hotwolf/TicTacToe/Hardware/RevA/Laser/OPILite/Order 54053/Design.dxf

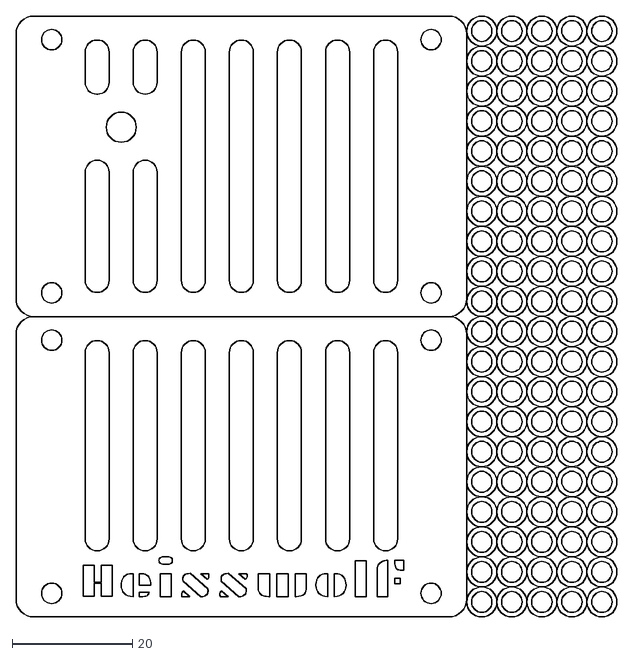
[picture p3: CAD file, 2017-04-25]
Hardware/RevA/Laser/OPILite/Order 54053/Design.dxf
100.0 x 100.0
