hotwolf/TicTacToe/Hardware/RevA/Laser/Plate/Order 53656/Design1.dxf

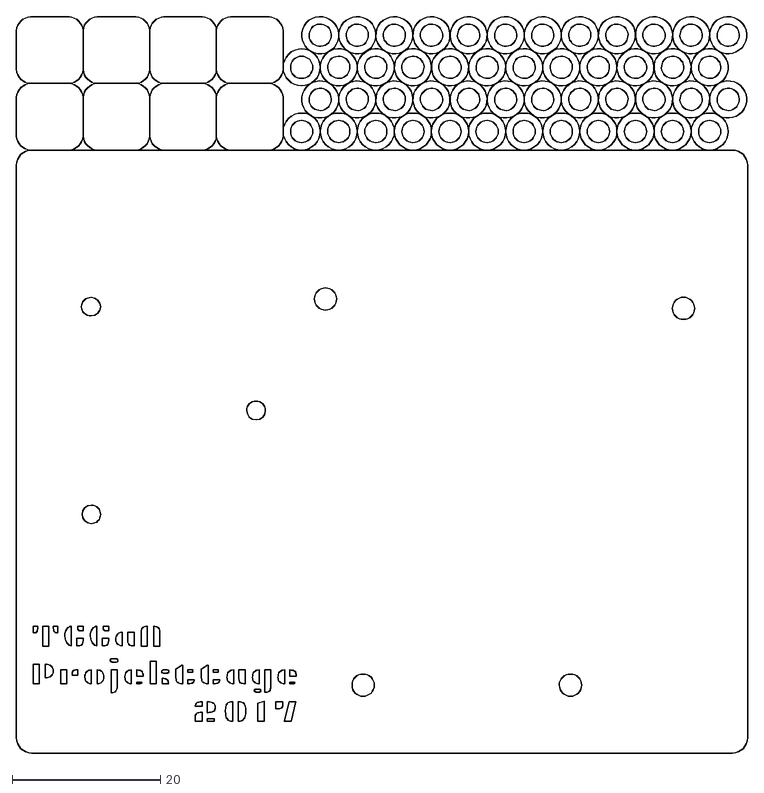
[picture p4: CAD file, 2017-04-25]
Hardware/RevA/Laser/Plate/Order 53656/Design1.dxf
98.6 x 99.4
