hotwolf/TicTacToe/Hardware/RevA/Laser/OPILite/Order 54053/Readme.pdf

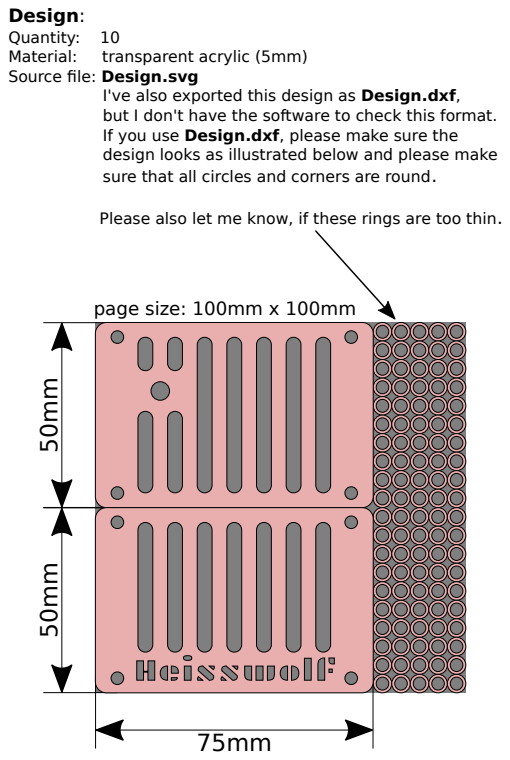
[picture p6: page 1]
Material:; transparent acrylic (5mm); page size: 100mm x 100mm

Design:
Quantity: 10
Source file: Design.svg

I've also exported this design as Design.dxf,
but I don't have the software to check this format.
If you use Design.dxf, please make sure the
design looks as illustrated below and please make
sure that all circles and corners are round.

Please also let me know, if these rings are too thin.
