hotwolf/TicTacToe/Hardware/RevA/TicTacToe-RevA Assembly Plan.pdf

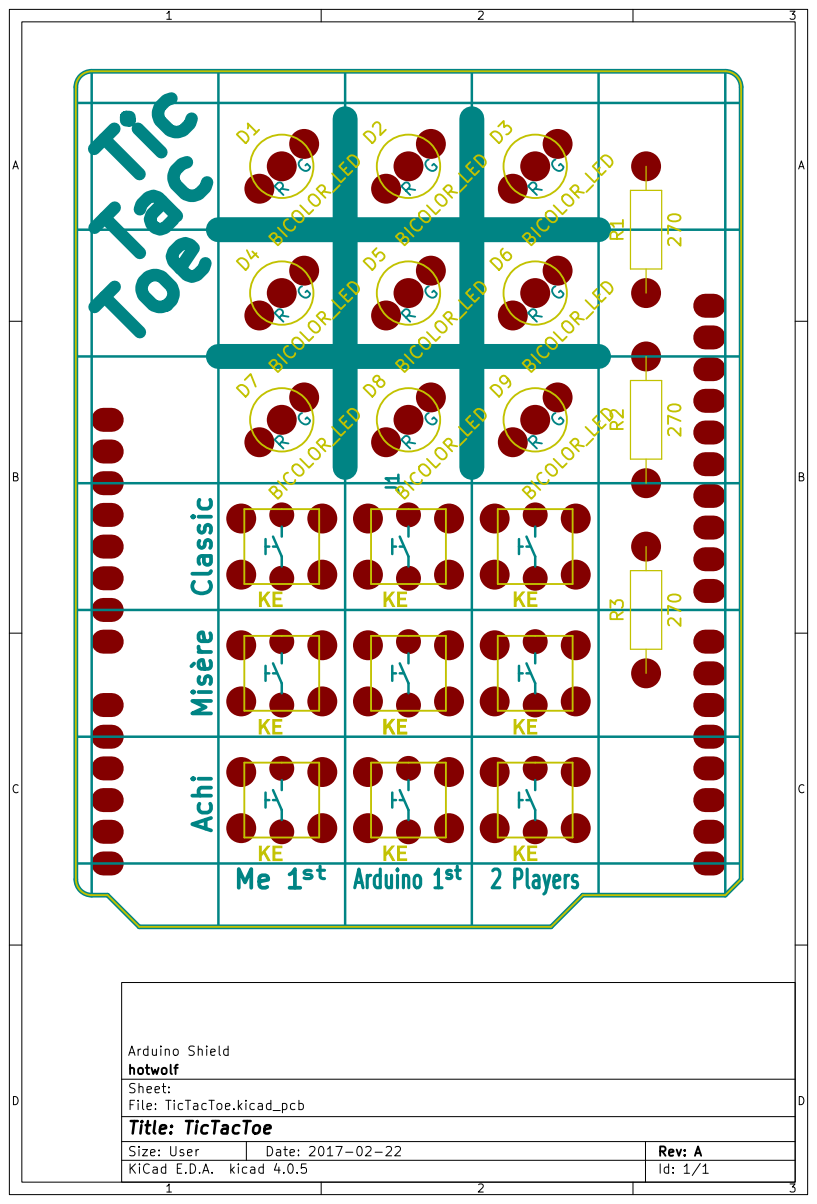
[picture p7: page 1]
