hotwolf/TicTacToe/Hardware/RevA/TicTacToe-RevA Schematic.pdf

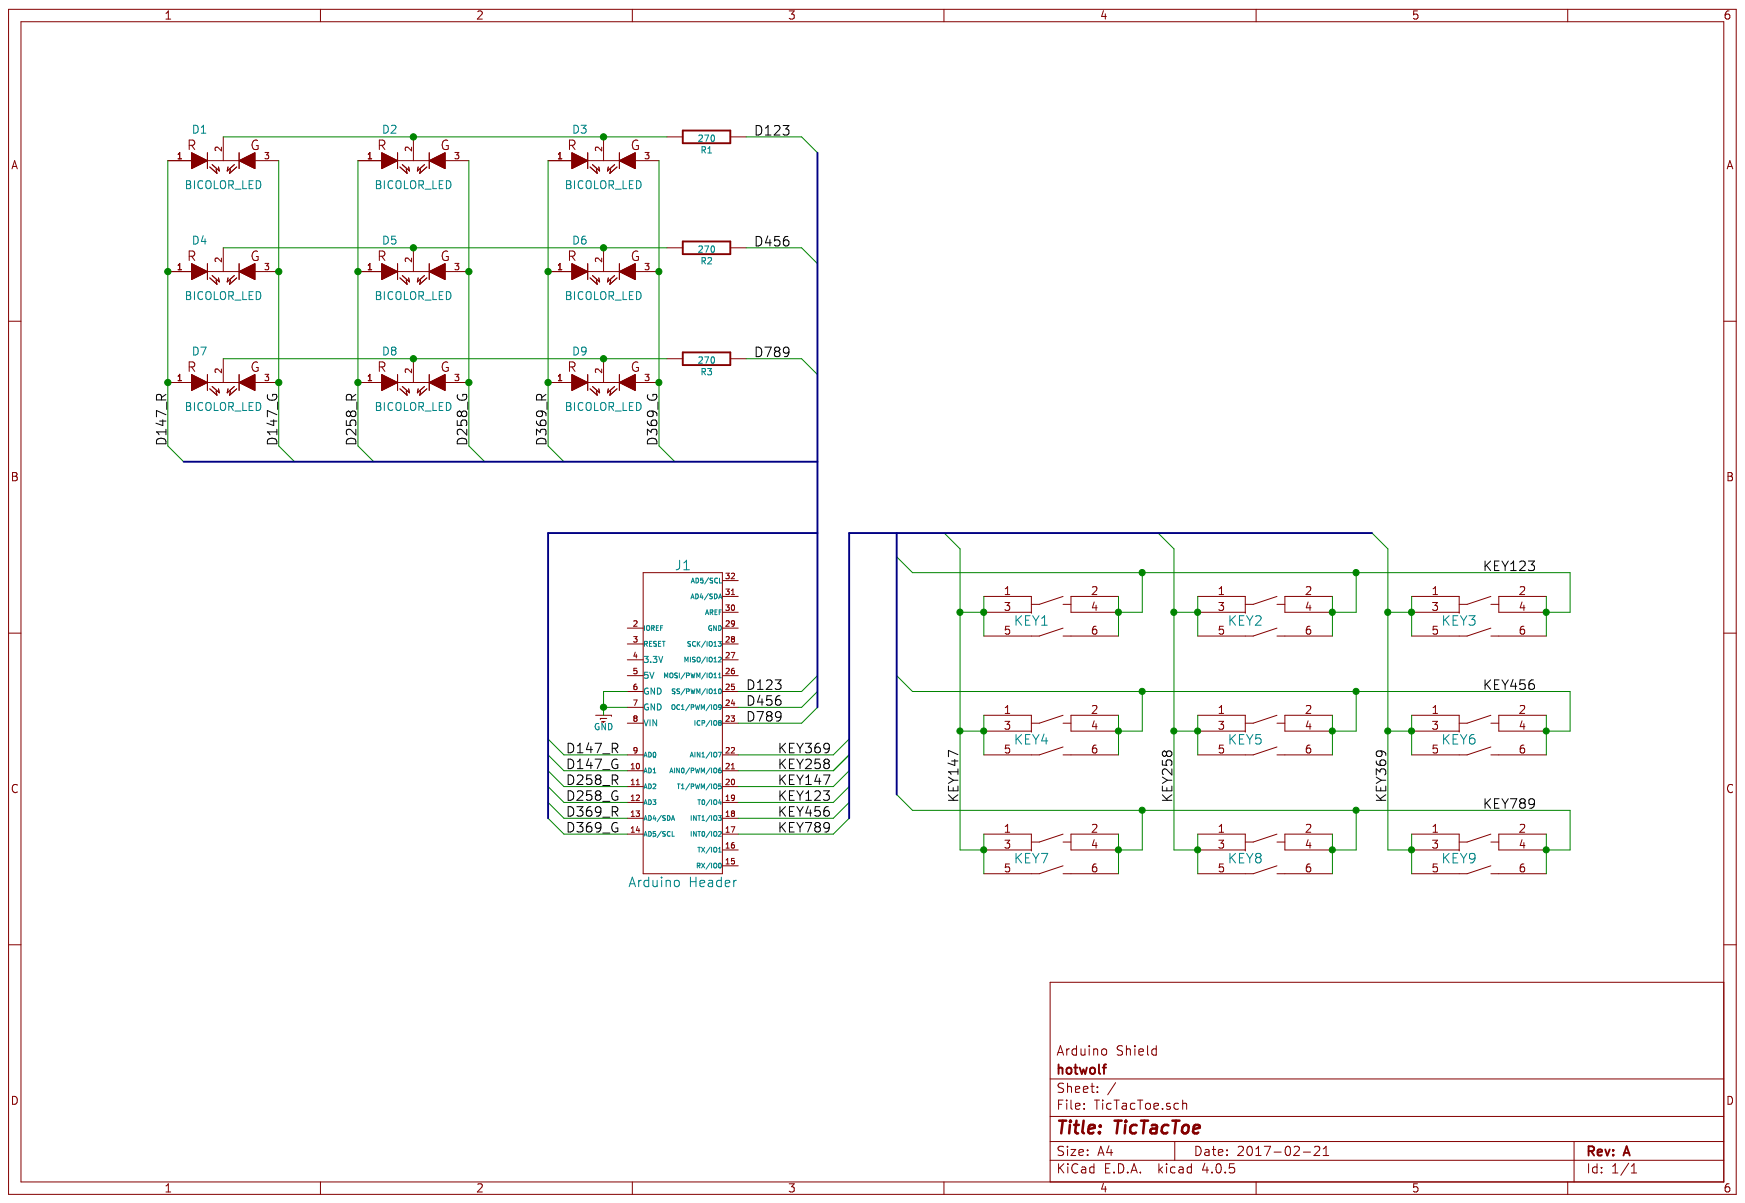
[picture p8: page 1]
