hotwolf/TicTacToe/Software/Lab4/Lab4.ino

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
#include "TicTacToe.h"

// Variables
//===========
fields gameSelection;
  
// Setup routine
//===============
void setup() {
  //Serial library
  //Serial.begin(9600);
  //Serial.println("Lab4!");

  //Random seed
  randomSeed(analogRead(0));
  
  //Display
  dispSetup();

  //Keypad
  keysSetup();

  //Intro text
  //Control characters: \x80 = loop
  //                    \x81 = display red text
  //                    \x82 = display green text
  //                    \x83 = display bicolor (red+green) text
  //                    \x84 = start of the loop
  //  
  //          green    red    green     loop
  //            V       V       V        V 
  //textShow("\x82TIC \x81TAC \x82TOE \x80");

  textShow("...put your own text here...\x80");  

  gameSelection = getKey();
  textStop();

}

// Game loop
//===========
void loop() {
  //Clear display
  red        = 0;
  green      = 0;
  scanRed    = 0;
  scanGreen  = 0;
  blinkRed   = 0;
  blinkGreen = 0;
  
  //Determine players
  if (gameSelection & 0b001001001) {
    //Me 1st
    greenIsHuman = true;
    redIsHuman   = false;
  } else if (gameSelection & 0b010010010) {
    //Arduino 1st
    greenIsHuman = false;
    redIsHuman   = true;
  } else {
    //Two players
    greenIsHuman = true;
    redIsHuman   = true;
  }
  
  //Start Game
  if (gameSelection & 0b000000111) {
    //Classic
    classicPlay();
  } else if (gameSelection & 0b000111000) {
    //Misere
    miserePlay();
  } else {
    //Achi
    achiPlay();
  }

  //Next game
  gameSelection = getKey();
}
