hotwolf/TicTacToe/Software/TicTacToe/TicTacToeDisp.ino

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
#include <Arduino.h>
#include <avr/sleep.h>
#include <avr/power.h>
#include "TicTacToe.h"

// Constants
//===========

// Variables                                
//===========
//Display buffer                                
fields       dispRedBuf     = 0;    //red display buffer
fields       dispGreenBuf   = 0;    //green display buffer

//Column index
byte         dispColumn     = 0;    //current column

//Pre-calculated port output
byte         dispNextPortB  = 0x07; //next port B output
byte         dispNextPortC  = 0x00; //next port C output

//Highlighting
signed char  dispHighlightCount = 0;//blink interval
fields       dispHighlightIndex = 0;//scan index
 
// Setup routine
//===============
void dispSetup() {
  //Initialize the display
  PORTB   &= 0xF8;
  PORTC   |= 0x3F;
  DDRB    |= 0x07;
  DDRC    |= 0x3F;

  //Initialize timer 2
  TCCR2A = 0;                               //normal mode
  //TCCR2A = (1 << WGM21);                  //CTC mode, no pin toggling
  TCCR2B = (1 << CS22) |                    //set timer clock to 15.625kHz
           (1 << CS21) |
           (1 << CS20);
  OCR2A  = 15625/(6*FRAMERATE);              //set interrupt frequency
  OCR2B  = 0;                               //
  TIFR2  = (1 << OCF2B) |                   //clear output compare B interrupt flag
           (1 << OCF2A);                    //clear output compare A interrupt flag
  TIMSK2 = (1 << OCIE2A);                   //enable output compare A interrupt
  
  //Power modes
  power_timer2_enable();                    //make sure timer2 is powered up
  set_sleep_mode(SLEEP_MODE_IDLE);          //use idle mode
  sleep_enable();                           //enable sleep instruction
}

// Interrupt Service Routines
//============================
//Timer2 output compare A interrupt
ISR(TIMER2_COMPA_vect){                     //timer2 output compare A interrupt
  fields tmpBuf;                            //intermediate display buffer

  //Debug code
  //digitalWrite(13, HIGH);                 //turn LED on during the execution of the ISR
  //digitalWrite(13, !digitalRead(13));     //turn LED on during the execution of the ISR

  //Prepare next delay 
  //OCR2A += 15625/(6*FRAMERATE);             //set new delay
  OCR2A =  (dispColumn & 1) ?                //compensate for different brightness
    OCR2A + ((15625*1.7)/(6*FRAMERATE)) :     //green
    OCR2A + ((15625*0.3)/(6*FRAMERATE));      //red
 
  //Drive previously calculated output
  PORTB |= 0x07;                            //turn off all LEDs
  PORTC  = dispNextPortC;                   //set new anode pattern
  PORTB &= dispNextPortB;                   //select new cathode column  
   
  //Update column
  dispColumn = ((dispColumn + 1) % 6);      //advance column indax

  //Update content
  if (!dispColumn) {                        //start of frame
    if (dispAnimator == NULL) {             //no custom animator

      //Set solid pattern
      dispRedBuf   = red;
      dispGreenBuf = green;

      //Highlighting
      if (++dispHighlightCount > (FRAMERATE/2)) {//advance blink interval
        dispHighlightCount = -(FRAMERATE/2);     //restart blink interval
        dispHighlightIndex = 0x001;             //restart scan
      } else if (dispHighlightCount > 0) {
  
        //Set blink pattern
        dispRedBuf   ^= blinkRed;
        dispGreenBuf ^= blinkGreen;

        //Set scan pattern
        if (!(dispHighlightCount % (FRAMERATE/(2*9)))) {//time to advance scan index
          while (dispHighlightIndex &&         
                (!(dispHighlightIndex & (scanRed | scanGreen)))) {
            dispHighlightIndex <<= 1;
          }
          //Serial.println(dispHighlightIndex, BIN);
          dispRedBuf   ^= (dispHighlightIndex & scanRed);
          dispGreenBuf ^= (dispHighlightIndex & scanGreen);
          dispHighlightIndex <<= 1;
        }
      }  
    } else {  
      //Run custom animation routine  
      dispAnimator(&dispRedBuf, &dispGreenBuf);   
    }
  }

  //Calculate next port output
  dispNextPortC = (0x01 << dispColumn);     //set cathode column
  tmpBuf = (dispColumn & 1) ?
    dispGreenBuf >> (dispColumn >> 1) :     //use green buffer
    dispRedBuf   >> (dispColumn >> 1);      //use red buffer
  dispNextPortB =
    ~(((tmpBuf & 0x40) >> 6) |              //set top row
      ((tmpBuf & 0x08) >> 2) |              //set center row
      ( tmpBuf & 0x01) << 2);               //set bottom row

  //Debug code
  //digitalWrite(13, LOW);                  //turn LED off
}
