hotwolf/TicTacToe/Software/Lab3/Lab3Exercise.ino

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
#include "TicTacToe.h"

// classicPlay()
//===============
//Play the classic game
// args:   none 
// result: none
void classicPlay () {
  //Game loop
  while (1) {

    //Green move
    //==========
    green = green | classicTurn(greenTurn);   //place green piece

    //Check if green won, otherwise check for a tie
 
       //...your code... (Tip: use "break;" to exit the while-loop)
   
    //Red move
    //========
    red = red | classicTurn(redTurn);         //place red piece

    //Check if red won

       //...your code... (Tip: use "break;" to exit the while-loop)

  }
}

// classicTurn()
//===============
//One turn of the classic game
// args:   color
// result: new mark to be placed
fields classicTurn(turn currentTurn) { 
  if ((currentTurn == greenTurn) ? greenIsHuman : redIsHuman) {
    return classicHumanTurn(currentTurn);
  } else {
    return classicComputerTurn(currentTurn);
  }
}

// classicHumanTurn()
//====================
//Human turn in the classic game
// args:   color
fields classicHumanTurn(turn currentTurn) {
  fields free   = inverseOf(red | green);
  fields input;

  //Highlight free fields
  if (currentTurn == greenTurn) {
    scanGreen = free;
  } else {
    scanRed   = free;
  } 

  //Get valid input
  do {
    input = getKey();

  } while (!(input & free));

  //Clear highlights
  scanGreen = 0;
  scanRed   = 0;

  return input;
}
