hotwolf/TicTacToe/(commit log)

2017-02-23 added PCB files
2017-03-16 Updated plate
2017-03-30 initial driver library
2017-04-13 added correction option for flipped LEDs
2017-04-25 fixed design files for laser cutting service
    [Design.dxf, Design1.dxf, Design2.dxf]
2017-06-28 started workshop materials
2017-06-29 finished assembly instruction
2017-07-02 cleaned up file permissions
    [Design.dxf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]
